1997wooji/capstondesign_nodeMCU_saferoad/project_code/motor/motor.ino

void setup() {

  pinMode(7, OUTPUT);       // Motor A 방향설정1

  pinMode(8, OUTPUT);       // Motor A 방향설정2

  pinMode(4, OUTPUT);       // Motor B 방향설정1

  pinMode(5, OUTPUT);       // Motor B 방향설정2

}



void loop() {

  /*모터A설정*/

  digitalWrite(7, HIGH);     // Motor A 방향설정1

  digitalWrite(8, LOW);      // Motor A 방향설정2

  analogWrite(9, 255);       // Motor A 속도조절 (0~255)

}
